sentientthings/IoT-Node/README.md

# IoT-Node
Hardware design files for the Sentient Things Iot Node
