sentientthings/IoT-Node/pdfs/IoT Node(Ver1.0)Schematic.pdf

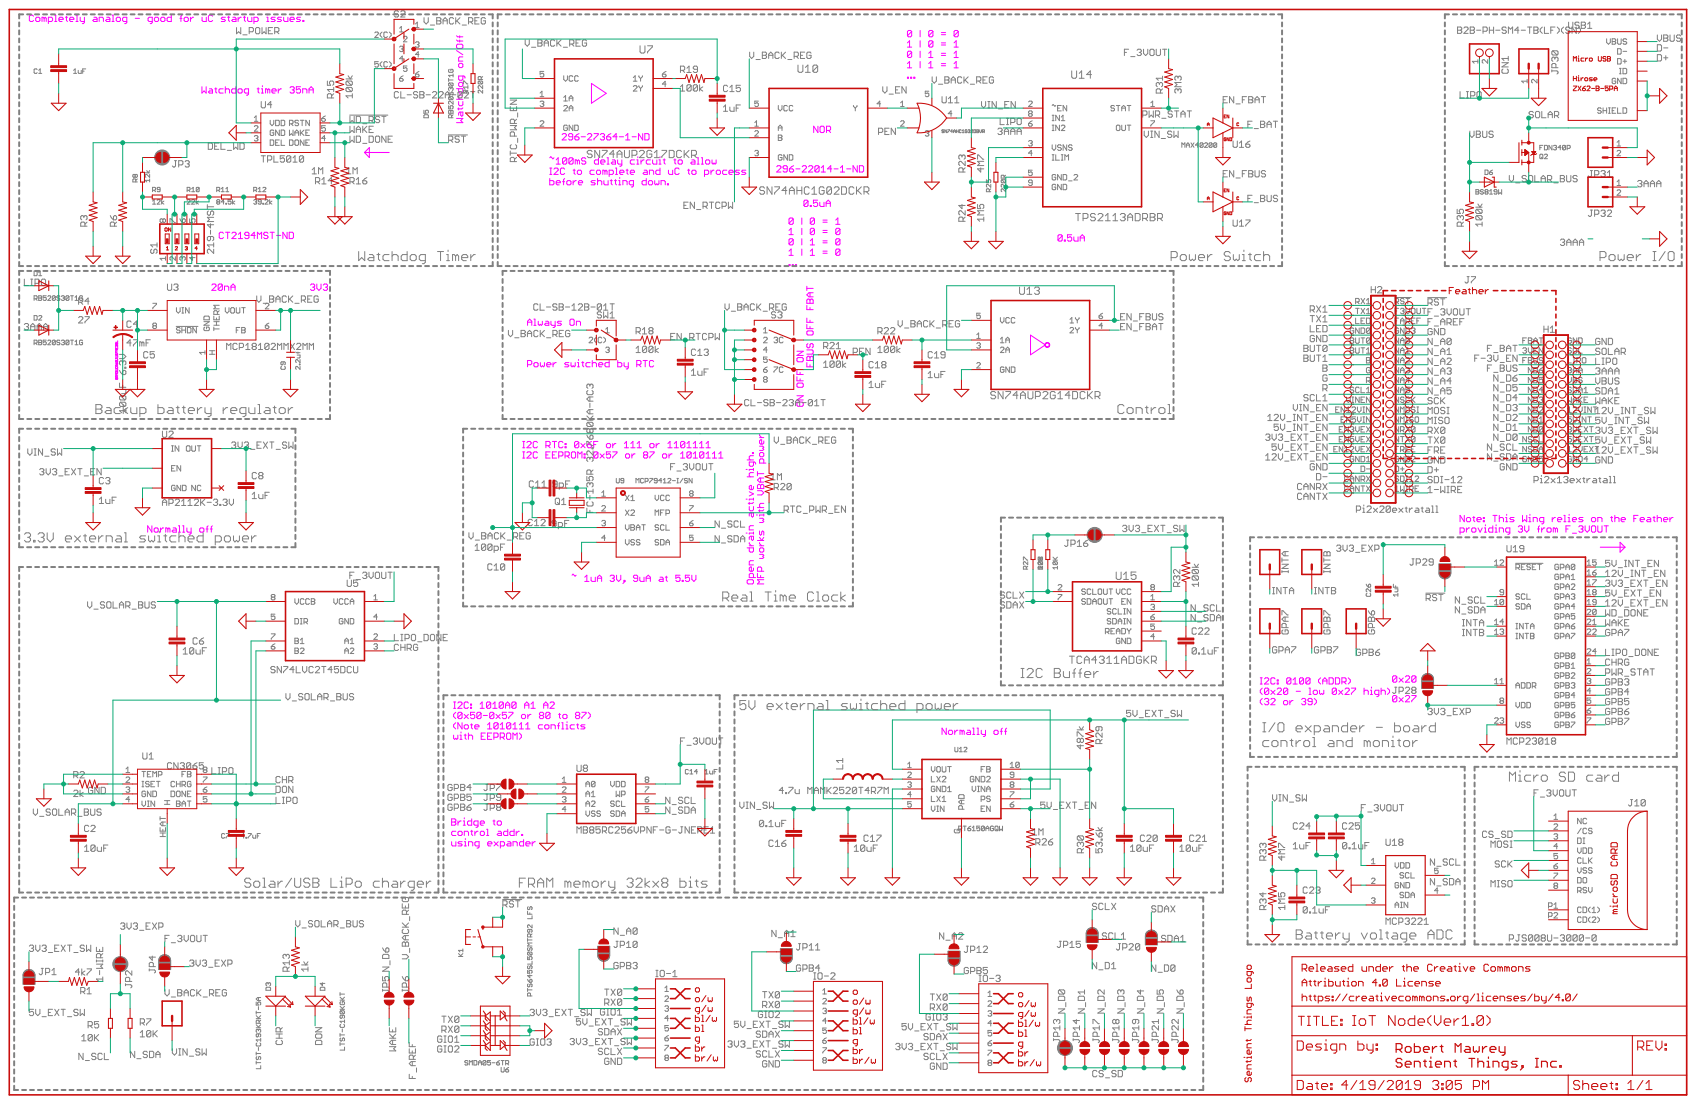
[picture p1: page 1]
