sentientthings/IoT-Node/eagle/IoT-Node-Ver1.0/IoT Node(Ver1.0).brd

## EAGLE design eagle/IoT-Node-Ver1.0/IoT Node(Ver1.0).brd (2019-05-07)

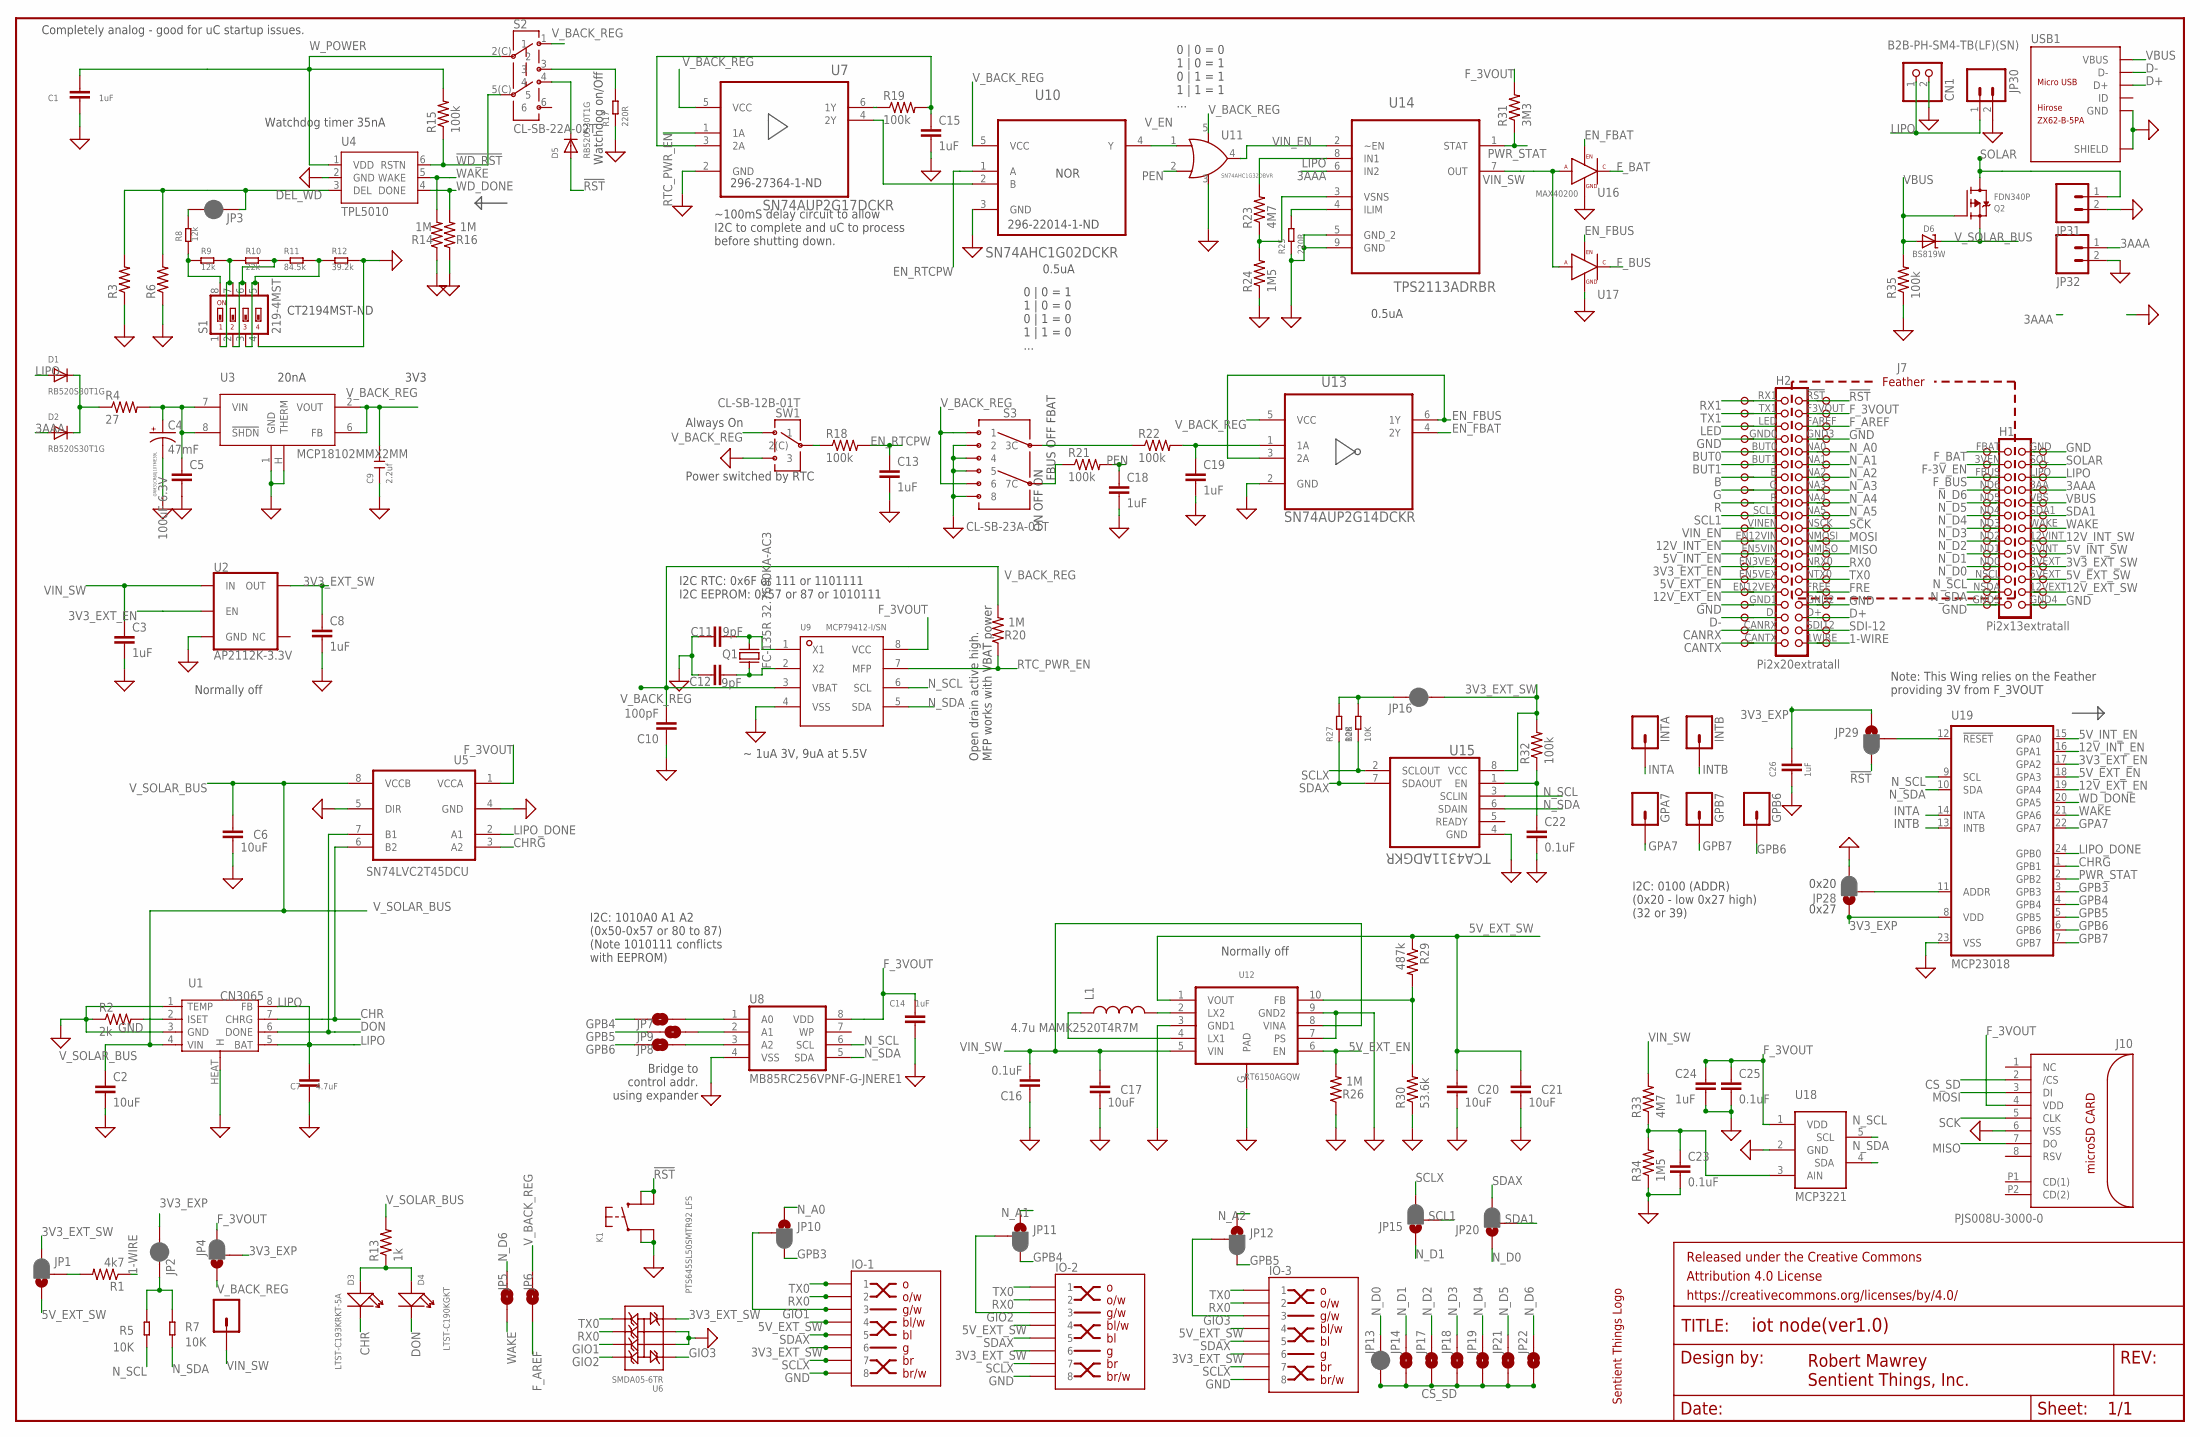
[picture p2: schematic IoT Node(Ver1.0).sch]

Parts:
C1, C3, C8, C13, C14, C15, C18, C19, C24, C26: 1uF; 0603-CAP; PARTNO CL10A105KP8NNNC
C2, C6, C17, C20, C21: 10uF; 0805; PARTNO CL21A106KPFNNNE
C4: 47mF; CAP-10.5MM; PARTNO FC0H473ZFTBR24
C5: 100uF 6.3V; C1206; PARTNO DNP
C7: 4.7uF; 0805; PARTNO CL10A475KP8NNNC
C9: 2.2uf; C0603; PARTNO CL10A106MQ8NNNC
C10: 100pF; 0805; PARTNO CL21C101JC61PNC
C11, C12: 9pF; 0603; PARTNO C1608C0G1H090D080AA
C16, C22, C23, C25: 0.1uF; 0603-CAP; PARTNO CL10F104ZB8NNNC
CN1: B2B-PH-SM4-TB(LF)(SN); JST-PH-2-SMT; PARTNO B2B-PH-SM4-TB(LF)(SN)?
D1, D2, D5: RB520S30T1G; SOD-523; PARTNO RB520S30T1G
D3: LTST-C193KRKT-5A; D0603; PARTNO LTST-C193KRKT-5A
D4: LTST-C190KGKT; D0603; PARTNO LTST-C190KGKT
D6: BS819W; SOD-123; PARTNO B5819WS-TP
FRAME1: FRAME-LEDGER; CREATIVE_COMMONS
GPA7: M01SMD-4.5X1.5; PAD-1.5X4.5; PARTNO DNP
GPB6, GPB7: M01SMD-4.5X1.5; PAD-1.5X4.5; PARTNO DNP
H1: Pi2x13extratall; 2X13PLACEMENT; PARTNO 2X13-ExtraTall
H2: Pi2x20extratall; 2X20PLACEMENT; PARTNO 2X20ExtraTall
INTA: M01SMD-4.5X1.5; PAD-1.5X4.5; PARTNO DNP
INTB: M01SMD-4.5X1.5; PAD-1.5X4.5; PARTNO DNP
IO-1, IO-2, IO-3: RJ45-8NODE-HOR; 73304111LF; PARTNO 73304-111LF
J1: CONN_01; 1X01; PARTNO DNP
J5, J6: M20IOTNODE; M20NODE; PARTNO DNP
J7: IOTNODEDOUBLE; IOTNODE; PARTNO DNP
J8, J9: M13NODE; 1X13NODE; PARTNO DNP
J10: PJS008U-3000-0; MICROSDYAMAICHI; PARTNO PJS008U-3000-0
JP1, JP4, JP10, JP11, JP12, JP15, JP20, JP28, JP29: JUMPER-SMT_3_1-NC_PASTE_NO-SILK; SMT-JUMPER_3_1-NC_PASTE_NO-SILK; PARTNO DNP
JP2, JP3, JP13, JP16: JUMPER-SMT_2_NC_PASTE_NO-SILK; SMT-JUMPER_2_NC_PASTE_NO-SILK; PARTNO DNP
JP5, JP6, JP7, JP8, JP9, JP14, JP17, JP18, JP19, JP21, JP22: JUMPER-SMT_2_NO_NO-SILK; SMT-JUMPER_2_NO_NO-SILK; PARTNO DNP
JP30: M021X02_LOCK_FEM; 1X02_LOCK_FEM; PARTNO 691322110002
JP31: M02SOCK; 1X02-3.5-HOR; PARTNO DNP
JP32: M02PLUG; 1X02_3.5TERM; PARTNO 691321100002
K1: PTS645SL50SMTR92 LFS; TACTILE6MM-ESWITCH; PARTNO PTS645SL50SMTR92 LFS
L1: 4.7u MAMK2520T4R7M; 2520; PARTNO MAMK2520T2R2M
N1: SENTIENTLOGO-ULP; SENTIENT_THINGS+50MM_TPLACE_BMP; PARTNO DNP
Q1: FC-135R 32.7680KA-AC3; FC135; PARTNO FC-135R 32.7680KA-AC3
Q2: FDN340P; SOT23-R; PARTNO FDN340P
R1: 4k7; 0603-RES; PARTNO RC0603JR-074K7L
R2: 2k; R0603; PARTNO ERJ-3GEYJ202V
R3, R6: RESISTOR0603-RES; 0603-RES; PARTNO DNP
R4: 27; 0603-RES; PARTNO RC0603JR-0727RL
R5, R7, R27, R28: 10K; R0603; PARTNO ERJ-3GEYJ103V
R8, R9: 12k; R0603; PARTNO ERJ-3GEYJ123V
R10: 22k; R0603; PARTNO ERJ-3GEYJ223V
R11: 84.5k; 0603; PARTNO RC0603FR-0784K5L
R12: 39.2k; 0603; PARTNO RC0603FR-0739K2L
R13: 1k; R0603; PARTNO ERJ-3GEYJ102V
R14, R16, R20, R26: 1M; 0603; PARTNO ERJ-3GEYJ105V
R15, R18, R19, R21, R22, R32, R35: 100k; 0603-RES; PARTNO ERJ-3GEYJ104V
R17, R25: 220R; R0603; PARTNO ERJ-3GEYJ221V
R23, R33: 4M7; 0603-RES; PARTNO ERJ-3GEYJ475V
R24, R34: 1M5; 0603-RES; PARTNO ERJ-3GEYJ155V
R29: 487k; 0603-RES; PARTNO RC0603FR-07487KL
R30: 53.6k; 0603-RES; PARTNO RC0603FR-0753K6L
R31: 3M3; 0603-RES; PARTNO ERJ-3GEYJ335V
S1: 219-4MST; SMS-004; PARTNO 219-4MST
S2: CL-SB-22A-02T; CL-SB-22A; PARTNO CL-SB-22A-02T
S3: CL-SB-23A-01T; CL-SB-23A; PARTNO CL-SB-23A-01T
SW1: CL-SB-12B-01T; CL-SB-12B; PARTNO CL-SB-12B-01T
U1: CN3065; DFN8; PARTNO CN3065
U2: AP2112K-3.3V; SOT23-5; PARTNO AP2112K-3.3TRG
U3: MCP18102MMX2MM; 8VDFN; PARTNO MCP1810T-33I/J8A
U4: TPL5010; SOT23-6; PARTNO TPL5010DDCT
U5: SN74LVC2T45DCU; US8-DCU; PARTNO SN74LVC2T45DCUR
U6: SMDA05-6TR; SOIC-8-STANDARD; PARTNO SMDA05-6TR
U7: SN74AUP2G17DCKR; SOT65P210X110-6N
U8: MB85RC256VPNF-G-JNERE1; SO08; PARTNO MB85RC256VPNF-G-JNERE1
U9: MCP79412-I/SN; RTC_MCP7941X; PARTNO MCP79412-I/SN
U10: SN74AHC1G02DCKR; SOT65P210X110-5N
U11: SN74AHC1G32DBVR; SOT23-5; PARTNO SN74AHC1G32DBVR
U12: RT6150AGQW; DFN103X3; PARTNO RT6150AGQW
U13: SN74AUP2G14DCKR; SOT65P210X110-6N
U14: TPS2113ADRBR; SON65P300X300X100-9N
U15: TCA4311ADGKR; SOP65P490X110-8N; PARTNO TCA4311ADGKR
U16, U17: MAX40200; SOT23-5; PARTNO MAX40200AUK+T
U18: MCP3221; SOT23-5; PARTNO MCP3221A5T-E/OT
U19: MCP23018; QFN24-4MM; PARTNO MCP23018-E/MJ
USB1: ZX62-B-5PA; MICRO-USB5+6P-SMD-0.65-AB; PARTNO ZX62-B-5PA(33)

Connections:
1-WIRE: J6.20, J7.1WIRE (40), R1.1
3AAA: D2.A, J7.3AA (60), J9.4, JP32.1, U14.6 (IN2)
3V3_EXP: C26.1, JP2.1, JP4.2, JP28.1, JP29.1, U19.8 (VDD)
3V3_EXT_EN: J5.14, J7.EN3VEX (27), U2.3 (EN), U19.17 (GPA2)
3V3_EXT_SW: C8.1, IO-1.6, IO-2.6, IO-3.6, J7.3VEXT (48), J9.10, JP1.3, JP16.1, R32.2, U2.5 (OUT), U6.8, U15.8 (VCC)
5V_EXT_EN: J5.15, J7.EN5VEX (29), R26.2, U12.6 (EN), U19.18 (GPA3)
5V_EXT_SW: C20.1, C21.1, IO-1.4, IO-2.4, IO-3.4, J7.5VEXT (46), J9.11, JP1.1, R29.1, U12.1 (VOUT)
5V_INT_EN: J5.13, J7.EN5VIN (25), U19.15 (GPA0)
5V_INT_SW: J7.5VINT (50), J9.9
12V_EXT_EN: J5.16, J7.EN12VEX (31), U19.19 (GPA4)
12V_EXT_SW: J7.12VEXT (44), J9.12
12V_INT_EN: J5.12, J7.EN12VIN (23), U19.16 (GPA1)
12V_INT_SW: J7.12VINT (52), J9.8
!RESET: JP29.2, U19.12 (!RESET)
!RST: D5.A, J6.1, J7.!RST (2), JP29.3, K1.2 (B0), K1.3 (B1)
!WD_RST: R15.1, S2.5(C) (5), U4.6 (RSTN)
B: J5.7, J7.B (13)
BUT0: J5.5, J7.BUT0 (9)
BUT1: J5.6, J7.BUT1 (11)
CANRX: J5.19, J7.CANRX (37)
CANTX: J5.20, J7.CANTX (39)
CHR: D3.-, U1.7 (CHRG), U5.6 (B2)
CHRG: U5.3 (A2), U19.1 (GPB1)
CS_SD: J10.2 (/CS), JP13.1, JP14.1, JP17.1, JP18.1, JP19.1, JP21.1, JP22.1
D+: J6.18, J7.D+ (36), USB1.3 (D+)
D-: J5.18, J7.D- (35), USB1.2 (D-)
DEL_WD: JP3.1, R3.2, R6.2, U4.3 (DEL)
DON: D4.-, U1.6 (DONE), U5.7 (B1)
EN_FBAT: U13.4 (2Y), U16.3 (EN)
EN_FBUS: U13.3 (2A), U13.6 (1Y), U17.3 (EN)
EN_RTCPW: C13.1, R18.2, U10.1 (A)
F-3V_EN: J7.3VEN (63), J8.2
FA0: JP7.2, U8.1 (A0)
FA1: JP9.2, U8.2 (A1)
FA2: JP8.2, U8.3 (A2)
FRE: J6.16, J7.FREE (32)
F_3VOUT: C14.1, C24.1, C25.1, J6.2, J7.F3VOUT (4), J10.4 (VDD), JP4.3, R31.2, U5.1 (VCCA), U8.8 (VDD), U9.8 (VCC), U18.1 (VDD)
F_AREF: J6.3, J7.FAREF (6), JP6.2
F_BAT: J7.FBAT (65), J8.1, U16.5 (C)
F_BUS: J7.FBUS (61), J8.3, U17.5 (C)
G: J5.8, J7.G (15)
GIO1: IO-1.3, JP10.2, U6.3
GIO2: IO-2.3, JP11.2, U6.4
GIO3: IO-3.3, JP12.2, U6.5
GND: C1.2, C2.2, C3.2, C4.-VE (-), C5.2, C6.2, C7.2, C8.2, C9.1, C10.1, C11.1 (ANODE), C12.1 (ANODE), C13.2, C14.2, C15.2, C16.1, C17.2, C18.2, C19.2, C20.2, C21.2, C22.2, C23.2, C24.2, C25.2, C26.2, CN1.2 (1), IO-1.8, IO-2.8, IO-3.8, J5.4, J5.17, J6.4, J6.17, J7.GND (66), J7.GND0 (7), J7.GND1 (33), J7.GND2 (34), J7.GND3 (8), J7.GND4 (42), J7.GND5 (41), J8.13, J9.1, J9.13, J10.6 (VSS), JP28.3, JP30.2, JP31.2, JP32.2, K1.1 (A0), K1.4 (A1), R2.1, R3.1, R6.1, R12.2, R14.1, R16.1, R17.1, R24.1, R25.1, R26.1, R30.1, R34.1, R35.1, S1.4, S3.2, S3.4, S3.5, S3.8, SW1.3, U1.1 (TEMP), U1.3 (GND), U1.HEAT (H), U2.2 (GND), U3.1 (GND), U3.H (THERM), U4.2 (GND), U5.4 (GND), U5.5 (DIR), U6.6, U6.7, U7.2 (GND), U8.4 (VSS), U9.4 (VSS), U10.3 (GND), U11.3 (G), U12.3 (GND1), U12.7 (PS), U12.9 (GND2), U12.G (PAD), U13.2 (GND), U14.5 (GND_2), U14.9 (GND), U15.4 (GND), U16.2 (G), U17.2 (G), U18.2 (GND), U19.23 (VSS), USB1.5 (GND), USB1.P1 (SHIELD), USB1.P2 (SHIELD), USB1.P3 (SHIELD), USB1.P4 (SHIELD), USB1.P5 (SHIELD), USB1.P6 (SHIELD)
GPA7: GPA7.P$1, U19.22 (GPA7)
GPB3: JP10.3, U19.3 (GPB3)
GPB4: JP7.1, JP11.3, U19.4 (GPB4)
GPB5: JP9.1, JP12.3, U19.5 (GPB5)
GPB6: GPB6.P$1, JP8.1, U19.6 (GPB6)
GPB7: GPB7.P$1, U19.7 (GPB7)
I2CPWR: JP2.2, R5.2, R7.2
INTA: INTA.P$1, U19.14 (INTA)
INTB: INTB.P$1, U19.13 (INTB)
LED: J5.3, J7.LED (5)
LIPO: C7.1, CN1.1 (2), D1.A, J7.LIPO (62), J9.3, JP30.1, R23.2, U1.5 (BAT), U1.8 (FB), U14.8 (IN1)
LIPO_DONE: U5.2 (A1), U19.24 (GPB0)
MISO: J6.13, J7.NMISO (26), J10.7 (DO)
MOSI: J6.12, J7.NMOSI (24), J10.3 (DI)
unnamed: JP3.2, R8.2
unnamed: R2.2, U1.2 (ISET)
unnamed: R17.2, S2.3
unnamed: R19.1, U7.6 (1Y)
unnamed: D3.+, D4.+, R13.1
unnamed: R18.1, SW1.C(2) (2(C))
unnamed: R25.2, U14.4 (ILIM)
unnamed: JP28.2, U19.11 (ADDR)
unnamed: R23.1, R24.2, U14.3 (VSNS)
unnamed: D1.K (C), D2.K (C), R4.1
unnamed: D5.K (C), S2.4
unnamed: C15.1, R19.2, U7.3 (2A)
unnamed: C11.2 (CATHODE), Q1.X2 (2), U9.1 (X1)
unnamed: C12.2 (CATHODE), Q1.X1 (1), U9.2 (X2)
unnamed: JP1.2, R1.2
unnamed: U7.4 (2Y), U10.2 (B)
unnamed: R9.2, R10.1, S1.1, S1.7
unnamed: R10.2, R11.1, S1.2, S1.6
unnamed: R11.2, R12.1, S1.3, S1.5
unnamed: R8.1, R9.1, S1.8
unnamed: C23.1, R33.1, R34.2, U18.3 (AIN)
unnamed: JP16.2, R27.2, R28.2
unnamed: L1.L2 (2), U12.2 (LX2)
unnamed: L1.L1 (1), U12.4 (LX1)
unnamed: R29.2, R30.2, U12.10 (FB)
unnamed: R21.1, S3.7(C) (7C)
unnamed: C22.1, R32.1, U15.1 (EN)
unnamed: C19.1, R22.2, U13.1 (1A)
unnamed: R22.1, S3.3(C) (3C)
N_A0: J6.5, J7.NA0 (10), JP10.1
N_A1: J6.6, J7.NA1 (12), JP11.1
N_A2: J6.7, J7.NA2 (14), JP12.1
N_A3: J6.8, J7.NA3 (16)
N_A4: J6.9, J7.NA4 (18)
N_A5: J6.10, J7.NA5 (20)
N_D0: J7.ND0 (47), J8.10, JP13.2, JP20.1
N_D1: J7.ND1 (49), J8.9, JP14.2, JP15.1
N_D2: J7.ND2 (51), J8.8, JP17.2
N_D3: J7.ND3 (53), J8.7, JP18.2
N_D4: J7.ND4 (55), J8.6, JP19.2
N_D5: J7.ND5 (57), J8.5, JP21.2
N_D6: J7.ND6 (59), J8.4, JP5.1, JP22.2
N_SCL: J7.NSCL (45), J8.11, R5.1, U8.6 (SCL), U9.6 (SCL), U15.3 (SCLIN), U18.5 (SCL), U19.9 (SCL)
N_SDA: J7.NSDA (43), J8.12, R7.1, U8.5 (SDA), U9.5 (SDA), U15.6 (SDAIN), U18.4 (SDA), U19.10 (SDA)
PEN: C18.1, R21.2, U11.2 (B)
PWR_STAT: R31.1, U14.1 (STAT), U19.2 (GPB2)
R: J5.9, J7.R (17)
RTC_PWR_EN: R20.1, U7.1 (1A), U9.7 (MFP)
RX0: IO-1.2, IO-2.2, IO-3.2, J6.14, J7.NRX0 (28), U6.2
RX1: J5.1, J7.RX1 (1)
SCK: J6.11, J7.NSCK (22), J10.5 (CLK)
SCL1: J5.10, J7.SCL1 (19), JP15.2
SCLX: IO-1.7, IO-2.7, IO-3.7, JP15.3, R28.1, U15.2 (SCLOUT)
SDA1: J7.SDA1 (56), J9.6, JP20.2
SDAX: IO-1.5, IO-2.5, IO-3.5, JP20.3, R27.1, U15.7 (SDAOUT)
SDI-12: J6.19, J7.SDI12 (38)
SOLAR: J7.SOL (64), J9.2, JP31.1, Q2.3 (D)
TX0: IO-1.1, IO-2.1, IO-3.1, J6.15, J7.NTX0 (30), U6.1
TX1: J5.2, J7.TX1 (3)
VBUS: D6.A, J7.VBS (58), J9.5, Q2.1 (G), R35.2, USB1.1 (VBUS)
VIN_EN: J5.11, J7.VINEN (21), U11.4 (Y), U14.2 (~EN)
VIN_SW: C3.1, C16.2, C17.1, J1.1, R33.2, U2.1 (IN), U12.5 (VIN), U12.8 (VINA), U14.7 (OUT), U16.1 (A), U17.1 (A)
V_BACK: C4.+VE (+), C5.1, R4.2, U3.7 (VIN), U3.8 (!SHDN)
V_BACK_REG: C9.2, C10.2, JP4.1, JP6.1, R20.2, S2.1, S3.1, S3.6, SW1.1, U3.2 (VOUT), U3.6 (FB), U7.5 (VCC), U9.3 (VBAT), U10.5 (VCC), U11.5 (V), U13.5 (VCC)
V_EN: U10.4 (Y), U11.1 (A)
V_SOLAR_BUS: C2.1, C6.1, D6.C, Q2.2 (S), R13.2, U1.4 (VIN), U5.8 (VCCB)
WAKE: J7.WAKE (54), J9.7, JP5.2, R14.2, U4.5 (WAKE), U19.21 (GPA6)
WD_DONE: R16.2, U4.4 (DONE), U19.20 (GPA5)
W_POWER: C1.1, R15.2, S2.2(C) (2), U4.1 (VDD)

Notes on the sheet:
Open drain active high. MFP works with VBAT power
Watchdog timer 35nA
~ 1uA 3V, 9uA at 5.5V
Always On Power switched by RTC
GRM31CR60J107ME39L
20nA
0.5uA
3V3
Watchdog on/Off
I2C RTC: 0x6F or 111 or 1101111 I2C EEPROM: 0x57 or 87 or 1010111
I2C: 0100 (ADDR) (0x20 - low 0x27 high) (32 or 39)
NOR
Normally off
0 | 0 = 1 1 | 0 = 0 0 | 1 = 0 1 | 1 = 0 ...
I2C: 1010A0 A1 A2 (0x50-0x57 or 80 to 87) (Note 1010111 conflicts with EEPROM)
Note: This Wing relies on the Feather providing 3V from F_3VOUT
0x20
0x27
Bridge to control addr. using expander
Robert Mawrey Sentient Things, Inc.
Completely analog - good for uC startup issues.
~100mS delay circuit to allow I2C to complete and uC to process before shutting down.
296-27364-1-ND
296-22014-1-ND
CT2194MST-ND
ON OFF ON
FBUS OFF FBAT
0 | 0 = 0 1 | 0 = 1 0 | 1 = 1 1 | 1 = 1 ...

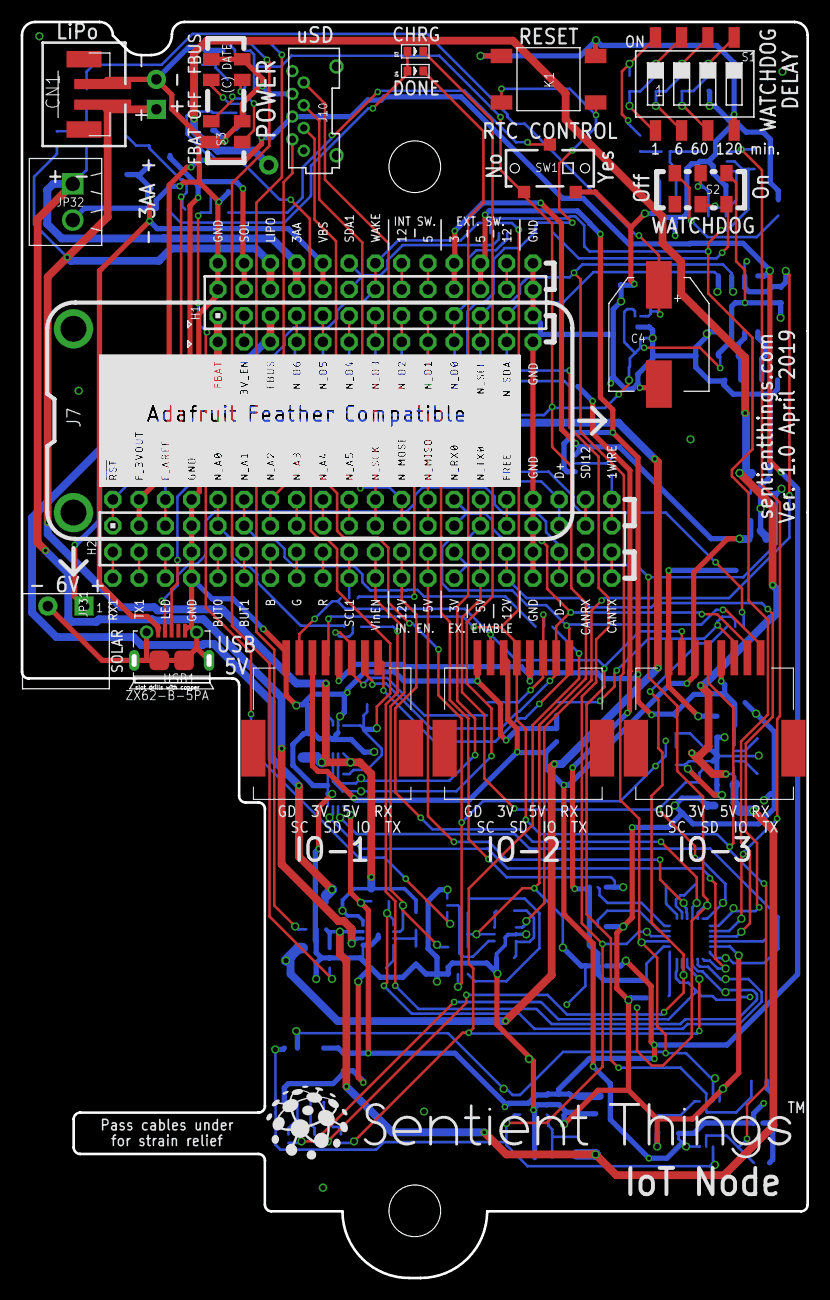
[picture p3: board IoT Node(Ver1.0).brd from above]

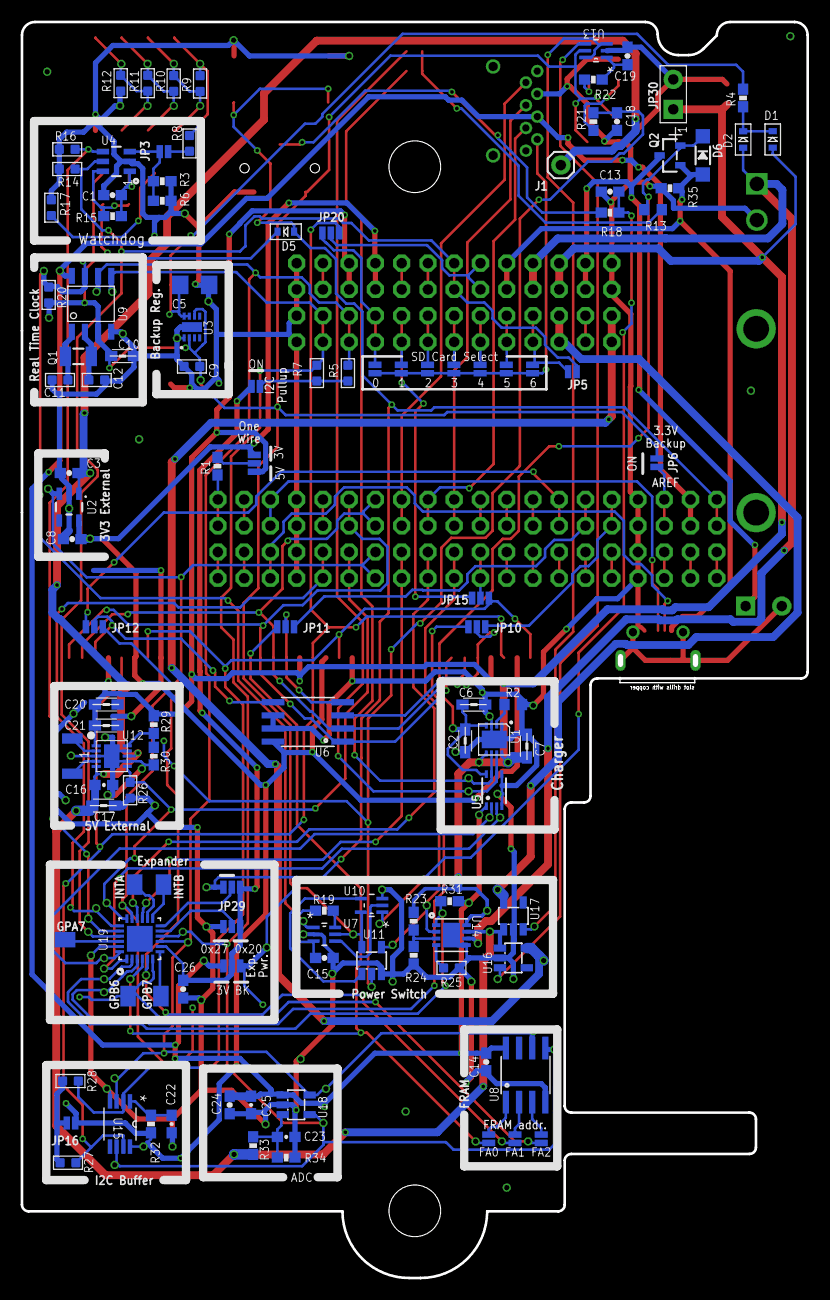
[picture p4: board IoT Node(Ver1.0).brd from below]

Board: 2 copper layers, 76.0 x 121.5 mm, 142 parts (117 on the bottom side), 128 nets.
